moonshin3z/anemo.uvg/docs/esquema_final_anemo.png

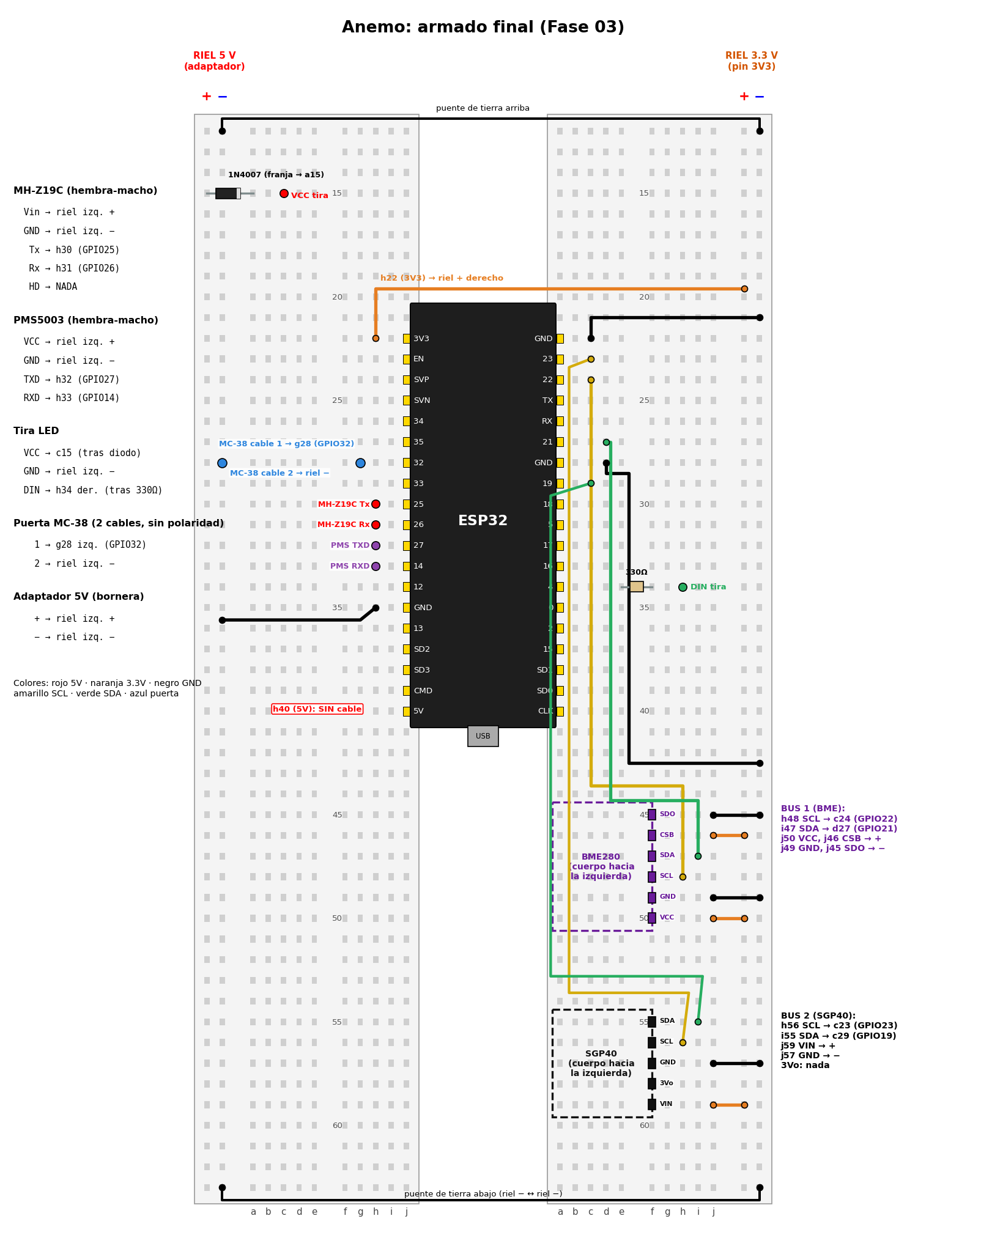
docs/esquema_final_anemo.png
