moonshin3z/anemo.uvg/docs/esquema_ventilador.png

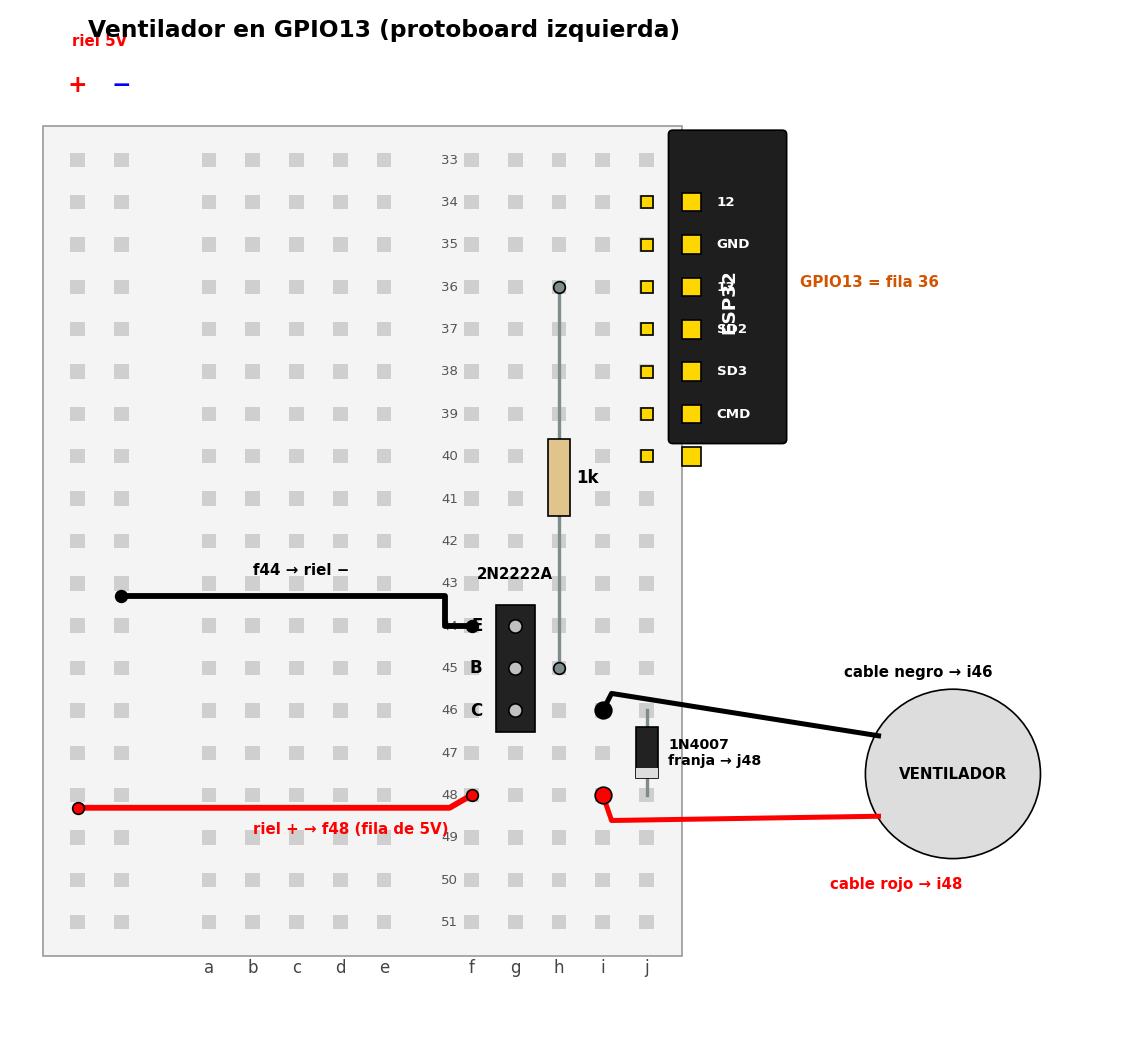
docs/esquema_ventilador.png
