moonshin3z/anemo.uvg/BITACORA.md

# Bitácora del proyecto

Formato de evidencias: `pXX_descripcion_tipo.ext` (ej. `p05_mhz19c_serial.png`) en `evidencias/`.
Videos pesados: en la carpeta compartida de Drive, con el link aquí.

## Paso 00: Repositorio y bitácora
- Fecha y responsable:
- Qué se hizo: repositorio creado con firmware, Raspberry Pi y documentación
- Resultado:
- Problemas y cómo se resolvieron:
- Evidencias:

## Paso 01: Inventario
- Fecha y responsable:
- Qué se hizo:
- Resultado:
- Problemas y cómo se resolvieron:
- Evidencias: p01_inventario_foto.jpg
