moonshin3z/anemo.uvg/(commit log)

2026-10-20 Fase 03: firmware ESP32, Raspberry Pi (MQTT + Firebase), docs y bitacora
2026-10-20 Renombrar proyecto a Anemo y agregar bitacora y carpeta de evidencias
    Claude-Session: https://claude.ai/code/session_01P1jWszjUFTkXRj39GG7CoJ
2026-10-20 Alerta de ventilar funciona con un solo sensor magnetico
    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
2026-10-21 Soporte para modulo con chip BMP280 (sin humedad) como respaldo del BME280
    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
2026-10-21 Telemetria incluye PM1.0 y PM10 ademas de PM2.5
    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
2026-10-22 Opcion de sensor de puerta cableado (MC-38) como respaldo del 433 MHz
    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
2026-10-22 RF 433: tolerancia de recepcion 80% (validado con autoprueba FS1000A)
    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
2026-10-22 Recuperacion automatica del bus I2C y timeout de 50 ms
    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
2026-10-22 Firmware: modo puerta simulada con FS1000A para la demo
    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
2026-10-22 Sketch de prueba de integracion de todos los modulos
    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
2026-10-25 Firmware: SGP40 en bus I2C propio, soporte BME680, temperatura de respaldo del MH-Z19C, RSSI y pendiente de CO2
    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
2026-10-25 Config: sensor de puerta MC-38 cableado en GPIO32
    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
2026-10-25 Docs: SGP40 bajado a filas 55-59 para que no choque con el BME280
    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
2026-10-25 LED: refresco cada 2 s para que la tira no se quede apagada tras un corte
    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
2026-10-25 Broker de prueba para la laptop mientras no esta la Raspberry
    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
2026-10-26 Borrador del informe de la Fase 03 y traspaso para Codex
    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
